AlanMendez1/Prueba/hardware/contorno_minima.dxf

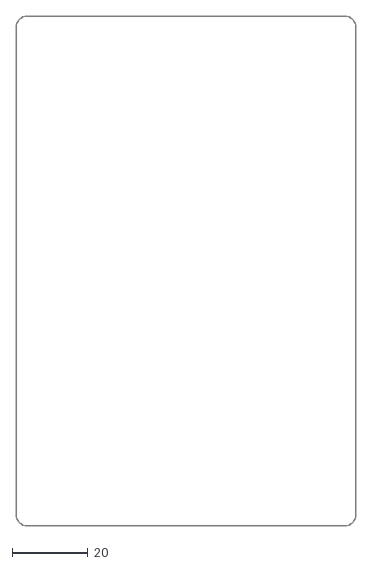
[picture p2: CAD file, 2026-10-13]
hardware/contorno_minima.dxf
90.0 x 135.0
