AlanMendez1/Prueba/(commit log)

2026-10-12 Firmware del prototipo mínimo de CalculadoraIA (fase 0)
    ESP32-S3 + TFT SPI (ILI9341/ST7789 vía TFT_eSPI) + matriz 5x5 directa
    en GPIO (24 teclas, sin MCP23017 ni cámara).
    - Modo calculadora: + - x / con precedencia, decimales, cursor,
    historial y encadenado sobre el último resultado.
    - F1: menú de preguntas predefinidas a Claude (Haiku 5.5, Messages API
    por HTTPS) sobre la operación actual; respuesta con scroll.
    - F2: vuelve a la calculadora.
    - Credenciales en src/secrets.h (ignorado por git).
    - Pruebas nativas de la lógica (pio test -e native).
    Claude-Session: https://claude.ai/code/session_01Q4MhaeT2kqUwuH23Yta6vw
2026-10-13 Usar Claude Opus 5.5 en el modo IA
    - Modelo claude-opus-5-5 con effort "medium" explícito (su default).
    - max_tokens 4096: en Opus 5.5 el razonamiento siempre está activo y
    cuenta dentro del límite.
    - Timeout HTTP a 60 s.
    - fallbacks "default" (beta server-side-fallback-2026-07-01): si el
    modelo declina, la API reintenta en otro modelo.
    - README actualizado (modelo, headers y costo estimado).
    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
2026-10-13 Anotar medida de la ventana de la Casio y comparación de pantallas
    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
2026-10-13 Registrar decisión de pantalla: TFT 2,8" ILI9341 con marco negro
    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
2026-10-13 Esquema, BOM y plano de la PCB mínima (fase 1)
    - hardware/: guía de conexiones para KiCad, BOM con huellas, contorno
    DXF 90x135 mm, plano de ubicación SVG y especificación de la placa
    (ESP32-S3-WROOM-1 soldado, TFT 2,8" enchufada, 24 pulsadores, USB-C,
    TP4056 con carga con la placa encendida, LDO AP2112K-3.3).
    - Firmware: entorno pcb (retroiluminación por P-MOSFET, activa en LOW);
    TFT_BACKLIGHT_ON definido por entorno.
    - Flechas reordenadas a ← ↑ ↓ → en la fila ROW4.
    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
    [BOM_minima.csv, contorno_minima.dxf]
2026-10-13 README: en protoboard, el LED de la pantalla va a 3V3
    Evita que IO21 alimente la retroiluminación directamente; enlaza la
    guía visual de armado.
    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
2026-10-13 Bajar la velocidad de carga a 115200
    En el primer intento de carga la escritura del flash no se verificó
    (MD5 de 0xFF); grabar más lento es la primera prueba.
    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
2026-10-13 README: subir por la entrada COM y borrar la flash si falla el MD5
    Lo aprendido en la primera carga real: la entrada USB nativa cambia de
    puerto en cada reinicio, y una N16R8 clónica (flash Boya) necesitó un
    erase_flash antes de aceptar escrituras.
    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
2026-10-14 Protoboard: mensajes por la entrada COM y SPI a 20 MHz
    - Entornos ili9341/st7789: Serial por UART0 (entrada COM del DevKitC),
    que es la que se usa para subir el programa; SPI de la TFT a 20 MHz
    para tolerar cables dupont largos.
    - Entorno pcb: sigue con Serial por USB nativo y SPI a 40 MHz.
    - main.cpp: mensajes de arranque, WiFi y teclas para diagnosticar.
    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
2026-10-14 Configurar memoria para el módulo N16R8 (DIO + PSRAM octal)
    Con la configuración por defecto de esp32-s3-devkitc-1 (qio_qspi) una
    N16R8 clónica (flash Boya) se reiniciaba en bucle durante el arranque
    (IllegalInstruction, watchdog). Se pasa a dio_opi: flash de 16 MB en
    modo DIO y PSRAM octal, que es lo que trae el módulo.
    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
2026-10-14 Pantalla ST7789 por defecto, sin inversión y en orden BGR
    La TFT roja de 2,8" (panel TPM408-2.8) es ST7789: con el driver ILI9341
    dibujaba 2/3 de la pantalla y con el driver ST7789 por defecto los
    colores salían invertidos y con rojo/azul cambiados. Se agrega la
    sección [st7789] (TFT_INVERSION_OFF, TFT_RGB_ORDER=TFT_BGR), se usa
    como entorno por defecto y también en el entorno pcb.
    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
2026-10-14 README: fase 0 probada en hardware de punta a punta
    Calculadora, menú IA y respuesta de Claude por WiFi funcionando en
    ESP32-S3 N16R8 + TFT ST7789 de 2,8". El teclado se probó uniendo pines;
    falta armar los 24 pulsadores.
    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
2026-10-14 Diagnóstico de WiFi: redes visibles y causa del fallo
    Al arrancar lista las redes de 2,4 GHz que ve el ESP32 e indica si la
    red configurada aparece. Cada cambio de estado se escribe por Serial
    con su causa (red no encontrada, clave incorrecta...), y en la pantalla
    de la calculadora se muestra un aviso corto.
    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
2026-10-14 Prueba del teclado original de la Casio (entorno casio_test)
    Escanea las 17 líneas del conector CN701 por pares, sin saber cuáles son
    filas o columnas, y muestra en la TFT un símbolo distinto por tecla, el
    par de líneas y los GPIO. Calibra al arrancar para ignorar líneas unidas
    de fábrica. El monitor serie imprime la línea lista para la tabla KEYS.
    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
2026-10-14 Prueba del teclado Casio para Arduino IDE (librería Adafruit ST7789)
    Mismo escaneo por pares que casio_test.cpp, con la pantalla configurada en
    el propio sketch (sin editar User_Setup.h de TFT_eSPI).
    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
2026-10-14 Teclado Casio enchufado directo al DevKit: líneas por GPIO
    El cable plano va directo a los pines del DevKit, así que cada línea se
    nombra por su GPIO. Se evitan 0/45 (arranque) y 35-37 (PSRAM), el pin 21
    pasa al teclado (LED de la TFT a 3V3) y los símbolos cubren los 253 pares.
    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
2026-10-14 Identificar teclas de la Casio solo por Monitor Serie
    Sketch sin pantalla: todos los pines en entrada con pull-up, uno a uno en
    salida LOW, antirrebote de 30 ms y número para cada tecla nueva.
    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
2026-10-14 Asignar nombres a las teclas de la Casio desde el Monitor Serie
    Al presionar una tecla se elige su nombre con el número de la lista de la
    fx-CG50 (o un nombre propio). Se guarda en la memoria del ESP32 y el
    comando 'tabla' imprime la tabla final.
    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
2026-10-14 Mapa medido del teclado original de la Casio
    38 teclas confirmadas en una matriz de 8 filas x 6 columnas, más lo que
    falta revisar: filas IO8/IO47 unidas y la columna izquierda sin respuesta.
    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
2026-10-15 Imagen del estado de cada tecla de la Casio
    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
2026-10-17 Sketch para saber qué punto T de la Casio va a cada pin
    Con un cable a GND se toca cada punto T y el Monitor Serie dice qué
    GPIO bajó a LOW.
    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
2026-10-17 Prueba de F1-F6 y flechas con lista de las que faltan
    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
